HacktoxX/sodimm-storage-box/src/dimensions.scad

/*
 * Zentrale abgeleitete Maße.
 *
 * Koordinatenkonvention:
 *   X: entlang der langen Kante jedes SO-DIMMs
 *   Y: quer zu den Aufbewahrungsreihen
 *   Z: vom tiefsten Stapelmerkmal bis zur offenen Oberseite
 *
 * Merkmalsmodule verwenden diese Werte statt Berechnungen zu wiederholen.
 * Alle Maße sind in Millimetern angegeben, sofern nicht anders vermerkt.
 */

// Primitive Eingaben prüfen, bevor abgeleitete Werte durch sie dividieren.
assert(
    sodimm_length > 0 && sodimm_height > 0 && sodimm_thickness > 0,
    "Alle nominellen SO-DIMM-Maße müssen positiv sein."
);
assert(
    slots_per_row >= 1 && slots_per_row == floor(slots_per_row),
    "slots_per_row muss eine ganze Zahl von mindestens 1 sein."
);
assert(
    row_count >= 1 && row_count == floor(row_count),
    "row_count muss eine ganze Zahl von mindestens 1 sein."
);
assert(
    full_box_short_rows >= 1 &&
    full_box_short_rows <= row_count &&
    full_box_short_rows == floor(full_box_short_rows),
    "full_box_short_rows muss eine ganze Zahl zwischen 1 und row_count sein."
);
assert(
    nozzle_diameter > 0,
    "nozzle_diameter muss positiv sein."
);
assert(
    layer_height > 0,
    "layer_height muss positiv sein."
);
assert(
    wall_thickness >= (2 * nozzle_diameter),
    "wall_thickness muss mindestens zwei Düsendurchmessern entsprechen."
);
assert(
    bottom_thickness >= (3 * layer_height),
    "bottom_thickness muss mindestens drei Druckschichten entsprechen."
);
assert(
    slot_length_clearance >= 0,
    "slot_length_clearance darf nicht negativ sein."
);
assert(
    slot_thickness_clearance >= 0,
    "slot_thickness_clearance darf nicht negativ sein."
);
assert(
    center_gap >= 0 && row_spacing >= 0,
    "Slotabstände dürfen nicht negativ sein."
);
assert(
    outer_margin_x >= 0 && outer_margin_y >= 0,
    "Außenränder dürfen nicht negativ sein."
);
assert(
    curve_resolution >= 12 &&
    curve_resolution == floor(curve_resolution),
    "curve_resolution muss eine ganze Zahl von mindestens 12 sein."
);
assert(
    body_material_reliefs == true || body_material_reliefs == false,
    "body_material_reliefs muss true oder false sein."
);
assert(
    insertion_depth > 0 && insertion_depth <= sodimm_height,
    "insertion_depth muss positiv sein und darf sodimm_height nicht überschreiten."
);
assert(
    access_grip_depth > 0 && access_grip_depth < insertion_depth,
    "access_grip_depth muss positiv und kleiner als insertion_depth sein."
);
assert(
    stacking_clearance >= 0,
    "stacking_clearance darf nicht negativ sein."
);
assert(
    stacking_feature_height > 0 && stacking_feature_top_width > 0,
    "Die Maße der Stapelfunktion müssen positiv sein."
);
assert(
    stacking_chamfer_angle > 0 && stacking_chamfer_angle <= 45,
    "Stapelfasen über 45 Grad sind nicht garantiert supportfrei druckbar."
);
assert(
    stacking_standoff > 0 &&
    stacking_standoff < stacking_feature_height,
    "stacking_standoff muss positiv und kleiner als stacking_feature_height sein."
);
assert(
    stacking_module_vertical_clearance >= 0,
    "stacking_module_vertical_clearance darf nicht negativ sein."
);
assert(
    stacking_min_feature_thickness >= (2 * nozzle_diameter),
    "stacking_min_feature_thickness muss mindestens zwei Düsendurchmessern entsprechen."
);
assert(
    stacking_min_edge_distance >= (2 * nozzle_diameter),
    "stacking_min_edge_distance muss mindestens zwei Düsendurchmessern entsprechen."
);
assert(
    stacking_min_backing_thickness >= (3 * layer_height),
    "stacking_min_backing_thickness muss mindestens drei Schichten entsprechen."
);
assert(
    corner_radius >= wall_thickness,
    "corner_radius muss für einen gültigen Innenradius mindestens wall_thickness entsprechen."
);
assert(
    label_mode == "engraved" ||
    label_mode == "raised",
    "label_mode muss \"engraved\" oder \"raised\" sein."
);
assert(
    label_width > 0 && label_height > 0 && label_depth > 0,
    "Die Beschriftungsmaße müssen positiv sein."
);
assert(
    is_string(label_text) && len(label_text) > 0,
    "label_text muss eine nichtleere Zeichenkette sein."
);
assert(
    is_string(label_font) && len(label_font) > 0,
    "label_font muss eine nichtleere Zeichenkette sein."
);
assert(
    label_depth >= layer_height &&
    label_panel_recess_depth >= layer_height,
    "Beschriftungs- und Feldtiefe müssen mindestens einer Schicht entsprechen."
);
assert(
    label_panel_bevel > 0 &&
    label_panel_bevel <= label_panel_recess_depth,
    "Die Feldfase muss positiv sein und darf die Feldtiefe nicht überschreiten."
);
assert(
    label_panel_padding >= nozzle_diameter,
    "Der Innenabstand des Beschriftungsfelds muss mindestens einer Düsenbreite entsprechen."
);
assert(
    label_panel_corner_radius > label_panel_bevel,
    "Der Feldradius muss größer als die Feldfase sein."
);
assert(
    label_character_width_ratio > 0,
    "label_character_width_ratio muss positiv sein."
);
assert(
    label_min_font_size > 0 &&
    label_min_font_size <= label_max_font_size,
    "label_min_font_size muss positiv und darf nicht größer als label_max_font_size sein."
);
assert(
    printer_build_x > 0 && printer_build_y > 0 && printer_build_z > 0,
    "Die Maße des Druckerbauraums müssen positiv sein."
);

// Ein Slot addiert explizites Fertigungsspiel zur nominellen Modulhülle.
slot_length = sodimm_length + slot_length_clearance;
function slot_width_with_clearance(thickness_clearance) =
    sodimm_thickness + thickness_clearance;
slot_width = slot_width_with_clearance(slot_thickness_clearance);

/*
 * Gemeinsame Matrixfunktionen sind die einzige Quelle für Slotfeld- und
 * Körpermaße. Kalibrierkörper, vollständige Box und Kurztest verwenden damit
 * dieselbe Positions- und Abstandskette.
 */
function slot_matrix_length_for(columns) =
    (columns * slot_length) + ((columns - 1) * center_gap);

function slot_matrix_width_for(rows, thickness_clearance) =
    (rows * slot_width_with_clearance(thickness_clearance)) +
    ((rows - 1) * row_spacing);

function storage_body_length_with_margin_for(columns, outer_margin) =
    slot_matrix_length_for(columns) +
    (2 * (outer_margin + wall_thickness));

function storage_body_width_with_margin_for(
    rows,
    thickness_clearance,
    outer_margin
) =
    slot_matrix_width_for(rows, thickness_clearance) +
    (2 * (outer_margin + wall_thickness));

function storage_body_length_for(columns) =
    storage_body_length_with_margin_for(columns, outer_margin_x);

function storage_body_width_for(rows, thickness_clearance) =
    storage_body_width_with_margin_for(
        rows,
        thickness_clearance,
        outer_margin_y
    );

// Das Slotfeld enthält alle Slots und nur die Abstände zwischen Nachbarn.
slot_area_length = slot_matrix_length_for(slots_per_row);
slot_area_width =
    slot_matrix_width_for(row_count, slot_thickness_clearance);

// Der Hauptkörper umschließt das Slotfeld mit Funktionsrand und Außenwand.
body_length = storage_body_length_for(slots_per_row);
body_width = storage_body_width_for(row_count, slot_thickness_clearance);
body_height = bottom_thickness + insertion_depth;

/*
 * Die Stapelschnittstelle ist noch nicht in den Grundkörper integriert. Für
 * die langfristige P1S-Prüfung wird ihre volle Höhe dennoch als konservative
 * zusätzliche Kontur oberhalb des unveränderten Körpers reserviert.
 */
box_length = body_length;
box_width = body_width;
box_height = body_height + stacking_feature_height;

// Die Kapazität wird einmal abgeleitet, damit jedes Teilsystem denselben Wert meldet.
total_slot_count = slots_per_row * row_count;

// Der Kurztest reduziert ausschließlich die Reihenzahl derselben Matrix.
full_box_short_slot_count = slots_per_row * full_box_short_rows;
full_box_short_slot_area_length =
    slot_matrix_length_for(slots_per_row);
full_box_short_slot_area_width =
    slot_matrix_width_for(
        full_box_short_rows,
        slot_thickness_clearance
    );
full_box_short_body_length = storage_body_length_for(slots_per_row);
full_box_short_body_width =
    storage_body_width_for(
        full_box_short_rows,
        slot_thickness_clearance
    );
full_box_short_body_height = body_height;

/*
 * Funktionale Entnahmezone und materialoptimierte Randbereiche.
 *
 * Die Randreliefs enden so weit vor den erweiterten Slotöffnungen, dass die
 * minimale Außenwand exakt wall_thickness erhält. Sie sind nach oben offen
 * und erzeugen daher weder Decken noch Brücken.
 */
access_grip_bottom_width = center_gap;
access_grip_top_width =
    access_grip_bottom_width + (2 * access_grip_depth);
access_grip_remaining_web_height = body_height - access_grip_depth;

body_relief_depth_x = outer_margin_x - slot_chamfer_expansion;
body_relief_depth_y = outer_margin_y - slot_chamfer_expansion;
body_relief_corner_radius = wall_thickness / 2;
body_relief_height = body_height - bottom_thickness;
body_calculation_epsilon = layer_height / 100;

body_min_outer_wall_x =
    (wall_thickness + outer_margin_x - slot_chamfer_expansion) -
    body_relief_depth_x;
body_min_outer_wall_y =
    (wall_thickness + outer_margin_y - slot_chamfer_expansion) -
    body_relief_depth_y;
body_load_bearing_row_web_width = row_spacing;
body_entry_row_web_width =
    row_spacing - (2 * slot_chamfer_expansion);
body_center_web_width = center_gap;
body_entry_center_web_width =
    center_gap - (2 * slot_chamfer_expansion);
body_contact_floor_thickness =
    bottom_thickness - slot_contact_relief_depth;

full_box_build_volume_ok =
    body_length <= printer_build_x &&
    body_width <= printer_build_y &&
    body_height <= printer_build_z;
full_box_build_volume_remaining_x = printer_build_x - body_length;
full_box_build_volume_remaining_y = printer_build_y - body_width;
full_box_build_volume_remaining_z = printer_build_z - body_height;

full_box_short_build_volume_ok =
    full_box_short_body_length <= printer_build_x &&
    full_box_short_body_width <= printer_build_y &&
    full_box_short_body_height <= printer_build_z;

// Ursprung des Slotfelds, gemessen von der unteren Außenecke des Körpers.
slot_start_x = wall_thickness + outer_margin_x;
slot_start_y = wall_thickness + outer_margin_y;

// Voll- und Kurzgrundkörper beginnen unverändert auf dem Druckbett.
body_start_z = 0;
slot_start_z = body_start_z + bottom_thickness;

// Diagnosewerte werden hier abgeleitet, um Rechnungen in echo() nicht zu wiederholen.
exposed_sodimm_height = sodimm_height - insertion_depth;
wall_line_count = wall_thickness / nozzle_diameter;
bottom_layer_count = bottom_thickness / layer_height;

/*
 * Die Bauraumprüfung verwendet die vollständige druckbare Hülle. box_height
 * enthält bereits die reservierte spätere Konturhöhe. X und Y bleiben bis zur
 * physischen Freigabe der Schnittstelle identisch mit dem Grundkörper.
 */
build_volume_ok =
    box_length <= printer_build_x &&
    box_width <= printer_build_y &&
    box_height <= printer_build_z;
build_volume_remaining_x = printer_build_x - box_length;
build_volume_remaining_y = printer_build_y - box_width;
build_volume_remaining_z = printer_build_z - box_height;

// Die vollständige Kette abgeleiteter Innen- und Außenmaße prüfen.
assert(
    slot_length > 0 && slot_width > 0,
    "Die abgeleiteten Slotmaße müssen positiv sein."
);
assert(
    slot_area_length > 0 && slot_area_width > 0,
    "Die abgeleiteten Maße des Slotfelds müssen positiv sein."
);
assert(
    body_length > 0 && body_width > 0 && body_height > 0,
    "Die abgeleiteten Körpermaße müssen positiv sein."
);
assert(
    box_length > 0 && box_width > 0 && box_height > 0,
    "Die abgeleiteten Gesamtmaße der Box müssen positiv sein."
);
assert(
    corner_radius <= (min(body_length, body_width) / 2),
    "corner_radius darf die Hälfte der kürzesten Körperabmessung nicht überschreiten."
);
assert(
    exposed_sodimm_height >= 0,
    "Die abgeleitete freiliegende SO-DIMM-Höhe darf nicht negativ sein."
);
assert(
    row_spacing >= wall_thickness,
    "row_spacing muss für einen tragenden Reihensteg mindestens wall_thickness entsprechen."
);
assert(
    center_gap >= wall_thickness,
    "center_gap muss für einen tragenden Mittelsteg mindestens wall_thickness entsprechen."
);
assert(
    access_grip_remaining_web_height >=
        (bottom_thickness + wall_thickness),
    "Die Entnahmezone lässt zu wenig tragende Höhe im Mittelsteg stehen."
);
assert(
    body_entry_row_web_width > 0,
    "Die Einführfasen benachbarter Reihen kollidieren."
);
assert(
    body_entry_center_web_width >= wall_thickness,
    "Die Einführfasen lassen am Mittelsteg weniger als wall_thickness stehen."
);
assert(
    body_contact_floor_thickness >= (3 * layer_height),
    "Der Boden unter der Kontaktentlastung muss mindestens drei Schichten stark bleiben."
);
assert(
    !body_material_reliefs ||
    (
        body_relief_depth_x > 0 &&
        body_relief_depth_y > 0 &&
        body_relief_height > 0
    ),
    "Die aktivierten Materialreliefs benötigen positive Abmessungen."
);
assert(
    !body_material_reliefs ||
    (
        body_min_outer_wall_x + body_calculation_epsilon >= wall_thickness &&
        body_min_outer_wall_y + body_calculation_epsilon >= wall_thickness
    ),
    "Die Materialreliefs unterschreiten die minimale Außenwandstärke."
);
assert(
    body_length <= printer_build_x,
    str(
        "Die Grundkörperlänge von ",
        body_length,
        " mm überschreitet printer_build_x von ",
        printer_build_x,
        " mm."
    )
);
assert(
    body_width <= printer_build_y,
    str(
        "Die Grundkörperbreite von ",
        body_width,
        " mm überschreitet printer_build_y von ",
        printer_build_y,
        " mm."
    )
);
assert(
    body_height <= printer_build_z,
    str(
        "Die Grundkörperhöhe von ",
        body_height,
        " mm überschreitet printer_build_z von ",
        printer_build_z,
        " mm."
    )
);
assert(
    full_box_short_body_length <= printer_build_x,
    "Der kurze Grundkörper überschreitet printer_build_x."
);
assert(
    full_box_short_body_width <= printer_build_y,
    "Der kurze Grundkörper überschreitet printer_build_y."
);
assert(
    full_box_short_body_height <= printer_build_z,
    "Der kurze Grundkörper überschreitet printer_build_z."
);

// Auf genau der Druckerachse fehlschlagen, die die Box nicht aufnehmen kann.
assert(
    box_length <= printer_build_x,
    str(
        "Die Boxlänge von ",
        box_length,
        " mm überschreitet printer_build_x von ",
        printer_build_x,
        " mm."
    )
);
assert(
    box_width <= printer_build_y,
    str(
        "Die Boxbreite von ",
        box_width,
        " mm überschreitet printer_build_y von ",
        printer_build_y,
        " mm."
    )
);
assert(
    box_height <= printer_build_z,
    str(
        "Die Boxhöhe von ",
        box_height,
        " mm überschreitet printer_build_z von ",
        printer_build_z,
        " mm."
    )
);

/*
 * Vier-Slot-Kalibrierkörper
 *
 * Diese Funktionen halten die Testvarianten parametergesteuert. Die Slotmaße
 * der späteren Box bleiben die verbindliche Quelle; nur das Dickenspiel
 * unterscheidet sich zwischen den Kalibrierkörpern.
 */
function slot_test_field_length_for(columns) =
    slot_matrix_length_for(columns);

function slot_test_field_width_for(thickness_clearance, rows) =
    slot_matrix_width_for(rows, thickness_clearance);

function slot_test_body_length_for(columns) =
    slot_test_field_length_for(columns) + (2 * slot_test_edge_width);

function slot_test_body_width_for(thickness_clearance, rows) =
    slot_test_field_width_for(thickness_clearance, rows) +
    (2 * slot_test_edge_width);

assert(
    render_mode == "debug" ||
    render_mode == "slot_test" ||
    render_mode == "full_box" ||
    render_mode == "full_box_short" ||
    render_mode == "stacking_test" ||
    render_mode == "stacking_test_variants" ||
    render_mode == "final_box",
    "render_mode muss \"debug\", \"slot_test\", \"full_box\", \"full_box_short\", \"stacking_test\", \"stacking_test_variants\" oder \"final_box\" sein."
);
assert(
    slot_test_rows >= 1 && slot_test_rows == floor(slot_test_rows),
    "slot_test_rows muss eine ganze Zahl von mindestens 1 sein."
);
assert(
    slot_test_columns >= 1 &&
    slot_test_columns == floor(slot_test_columns),
    "slot_test_columns muss eine ganze Zahl von mindestens 1 sein."
);
assert(
    slot_chamfer_height > 0,
    "slot_chamfer_height muss positiv sein."
);
assert(
    slot_chamfer_expansion >= 0,
    "slot_chamfer_expansion darf nicht negativ sein."
);
assert(
    slot_chamfer_expansion <= slot_chamfer_height,
    "slot_chamfer_expansion darf slot_chamfer_height nicht überschreiten; die Einführfläche wäre steiler als 45 Grad."
);
assert(
    slot_chamfer_height < insertion_depth,
    "slot_chamfer_height muss kleiner als insertion_depth sein."
);
assert(
    slot_contact_support_length > 0 &&
    (2 * slot_contact_support_length) < slot_length,
    "slot_contact_support_length muss einen offenen Bereich für die Kontaktfreistellung lassen."
);
assert(
    slot_contact_relief_depth > 0,
    "slot_contact_relief_depth muss positiv sein."
);
assert(
    (bottom_thickness - slot_contact_relief_depth) >= (3 * layer_height),
    "Der Boden unter der Kontaktfreistellung muss mindestens drei Schichten stark bleiben."
);
assert(
    slot_test_outer_margin >= wall_thickness,
    "slot_test_outer_margin muss mindestens wall_thickness erhalten."
);
assert(
    access_grip_depth > 0,
    "access_grip_depth muss positiv sein."
);
assert(
    slot_test_variant_mode == true || slot_test_variant_mode == false,
    "slot_test_variant_mode muss true oder false sein."
);
assert(
    len(slot_test_clearance_variants) >= 1,
    "slot_test_clearance_variants muss mindestens einen Wert enthalten."
);
for (variant_clearance = slot_test_clearance_variants) {
    assert(
        variant_clearance >= 0,
        "Jedes Dickenspiel des Slot-Tests muss nichtnegativ sein."
    );
}
assert(
    slot_test_variant_spacing >= wall_thickness,
    "slot_test_variant_spacing muss mindestens wall_thickness entsprechen."
);

// Der Rand des Testkörpers ist nie dünner als die Wand der späteren Box.
slot_test_edge_width = max(wall_thickness, slot_test_outer_margin);

// Der Test verwendet Slotlänge, Mittelabstand und Reihenabstand der späteren Box.
slot_test_slot_length = slot_length;
slot_test_slot_width =
    slot_width_with_clearance(slot_thickness_clearance);
slot_test_field_length = slot_test_field_length_for(slot_test_columns);
slot_test_field_width =
    slot_test_field_width_for(slot_thickness_clearance, slot_test_rows);

slot_test_body_length = slot_test_body_length_for(slot_test_columns);
slot_test_body_width =
    slot_test_body_width_for(slot_thickness_clearance, slot_test_rows);
slot_test_body_height = bottom_thickness + insertion_depth;

// Die Slotanordnung beginnt hinter der kompakten Außenwand.
slot_test_slot_start_x = slot_test_edge_width;
slot_test_slot_start_y = slot_test_edge_width;
slot_test_slot_start_z = bottom_thickness;

// Die gerade Führung endet am Beginn der symmetrischen oberen Fase.
slot_straight_guide_depth = insertion_depth - slot_chamfer_height;

/*
 * Zwei Endauflagen bleiben auf dem nominellen Bodenniveau stehen. Die
 * Freistellung dazwischen schützt die Kontaktkante und erhält einen
 * druckbaren geschlossenen Boden.
 */
slot_contact_relief_length =
    slot_test_slot_length - (2 * slot_contact_support_length);
slot_contact_floor_thickness =
    bottom_thickness - slot_contact_relief_depth;

/*
 * Die Entnahmeöffnung beginnt mit dem vollständigen Mittelabstand und erweitert
 * sich horizontal um einen Millimeter je vertikalem Millimeter. Ihre
 * 45-Grad-Flächen sind supportfrei.
 */
slot_test_grip_bottom_width = center_gap;
slot_test_grip_top_width = access_grip_top_width;
slot_test_remaining_center_web_height =
    access_grip_remaining_web_height;

// Explizite Stegberechnungen belegen, dass benachbarte Fasen nicht kollidieren.
slot_test_column_web_width = center_gap;
slot_test_row_web_width = row_spacing;
slot_test_chamfer_column_web_width =
    slot_test_column_web_width - (2 * slot_chamfer_expansion);
slot_test_chamfer_row_web_width =
    slot_test_row_web_width - (2 * slot_chamfer_expansion);
slot_test_chamfer_outer_wall =
    slot_test_edge_width - slot_chamfer_expansion;

// Eine aus der Schichthöhe abgeleitete Überlappung vermeidet koplanare Booleans.
modeling_overlap = layer_height / 10;
slot_test_boolean_overlap = modeling_overlap;

// Der Variantenabstand verwendet unabhängig von der Reihenfolge den breitesten Körper.
slot_test_variant_count = len(slot_test_clearance_variants);
slot_test_max_variant_clearance =
    slot_test_variant_count > 0
        ? max(slot_test_clearance_variants)
        : slot_thickness_clearance;
slot_test_max_variant_body_width =
    slot_test_body_width_for(
        slot_test_max_variant_clearance,
        slot_test_rows
    );
slot_test_variant_pitch =
    slot_test_max_variant_body_width + slot_test_variant_spacing;
slot_test_variants_width =
    (slot_test_variant_count * slot_test_max_variant_body_width) +
    ((slot_test_variant_count - 1) * slot_test_variant_spacing);

// Die gesamte Renderhülle wechselt zwischen Einzelkörper und Variantenanordnung.
slot_test_render_length = slot_test_body_length;
slot_test_render_width =
    slot_test_variant_mode
        ? slot_test_variants_width
        : slot_test_body_width;
slot_test_render_height = slot_test_body_height;
slot_test_build_volume_ok =
    slot_test_render_length <= printer_build_x &&
    slot_test_render_width <= printer_build_y &&
    slot_test_render_height <= printer_build_z;

assert(
    slot_test_slot_width > 0,
    "Die abgeleitete Breite des Slot-Tests muss positiv sein."
);
assert(
    slot_test_body_length > 0 &&
    slot_test_body_width > 0 &&
    slot_test_body_height > 0,
    "Alle abgeleiteten Körpermaße des Slot-Tests müssen positiv sein."
);
assert(
    slot_contact_relief_length > 0,
    "Die Kontaktauflagen lassen keine mittige Kontaktfreistellung übrig."
);
assert(
    slot_test_remaining_center_web_height >=
        (bottom_thickness + wall_thickness),
    "Die Entnahmefreistellung lässt über dem Boden weniger als wall_thickness stehen."
);
assert(
    slot_test_chamfer_column_web_width > 0,
    "Die Spaltenfasen kollidieren über center_gap hinweg."
);
assert(
    slot_test_chamfer_row_web_width > 0,
    "Die Reihenfasen kollidieren über row_spacing hinweg."
);
assert(
    slot_test_chamfer_outer_wall >= (2 * nozzle_diameter),
    "Die Fase lässt an der Außenwand weniger als zwei Düsendurchmesser stehen."
);
assert(
    slot_test_render_length <= printer_build_x,
    "Der Slot-Test überschreitet printer_build_x."
);
assert(
    slot_test_render_width <= printer_build_y,
    "Der Slot-Test überschreitet printer_build_y."
);
assert(
    slot_test_render_height <= printer_build_z,
    "Der Slot-Test überschreitet printer_build_z."
);

/*
 * Kalibriergeometrie der selbstzentrierenden Stapelschnittstelle.
 *
 * Der Winkel wird gegenüber der Druckebene gemessen. Bei 45 Grad entspricht
 * der horizontale Lauf exakt der vertikalen Höhe. Männliche und weibliche
 * Kontur greifen ausschließlich auf diese Funktionen zurück.
 */
function stacking_slope_run_per_height_for(chamfer_angle) =
    1 / tan(chamfer_angle);

function stacking_male_base_width_for(
    feature_height,
    feature_top_width,
    chamfer_angle
) =
    feature_top_width +
    (
        2 *
        feature_height *
        stacking_slope_run_per_height_for(chamfer_angle)
    );

function stacking_engagement_depth_for(feature_height, standoff) =
    feature_height - standoff;

function stacking_male_width_at_height_for(
    height,
    feature_height,
    feature_top_width,
    chamfer_angle
) =
    feature_top_width +
    (
        2 *
        (feature_height - height) *
        stacking_slope_run_per_height_for(chamfer_angle)
    );

function stacking_female_opening_width_for(
    clearance,
    feature_height,
    feature_top_width,
    chamfer_angle,
    standoff
) =
    stacking_male_width_at_height_for(
        standoff,
        feature_height,
        feature_top_width,
        chamfer_angle
    ) + clearance;

function stacking_female_depth_for(
    clearance,
    feature_height,
    feature_top_width,
    chamfer_angle,
    standoff
) =
    stacking_female_opening_width_for(
        clearance,
        feature_height,
        feature_top_width,
        chamfer_angle,
        standoff
    ) /
    (
        2 *
        stacking_slope_run_per_height_for(chamfer_angle)
    );

stacking_slope_run_per_height =
    stacking_slope_run_per_height_for(stacking_chamfer_angle);
stacking_slope_run =
    stacking_feature_height * stacking_slope_run_per_height;
stacking_male_base_width =
    stacking_male_base_width_for(
        stacking_feature_height,
        stacking_feature_top_width,
        stacking_chamfer_angle
    );
stacking_engagement_depth =
    stacking_engagement_depth_for(
        stacking_feature_height,
        stacking_standoff
    );
stacking_female_opening_width =
    stacking_female_opening_width_for(
        stacking_clearance,
        stacking_feature_height,
        stacking_feature_top_width,
        stacking_chamfer_angle,
        stacking_standoff
    );
stacking_female_depth =
    stacking_female_depth_for(
        stacking_clearance,
        stacking_feature_height,
        stacking_feature_top_width,
        stacking_chamfer_angle,
        stacking_standoff
    );

// Das Gesamtspiel wird symmetrisch auf die beiden gegenüberliegenden Flanken verteilt.
stacking_clearance_per_side = stacking_clearance / 2;
stacking_female_width_at_male_top =
    stacking_female_opening_width -
    (
        2 *
        stacking_engagement_depth *
        stacking_slope_run_per_height
    );
stacking_calculated_total_clearance =
    stacking_female_width_at_male_top -
    stacking_feature_top_width;
stacking_roof_clearance =
    stacking_female_depth - stacking_engagement_depth;
stacking_lateral_capture =
    (
        stacking_female_opening_width -
        stacking_feature_top_width
    ) / 2;

// Zwei parallele Auflagenpaare tragen die obere Hälfte, bevor die Flanken klemmen können.
stacking_support_land_count = 4;
stacking_support_land_area =
    stacking_support_land_count *
    stacking_support_land_length *
    stacking_support_land_width;

stacking_test_male_outer_length =
    stacking_test_frame_length + stacking_male_base_width;
stacking_test_male_outer_width =
    stacking_test_frame_width + stacking_male_base_width;
stacking_test_male_inner_length =
    stacking_test_frame_length - stacking_male_base_width;
stacking_test_male_inner_width =
    stacking_test_frame_width - stacking_male_base_width;
stacking_test_female_outer_length =
    stacking_test_frame_length +
    stacking_male_base_width +
    stacking_clearance;
stacking_test_female_outer_width =
    stacking_test_frame_width +
    stacking_male_base_width +
    stacking_clearance;
stacking_test_max_clearance = max(stacking_clearance_variants);
stacking_test_max_female_outer_length =
    stacking_test_frame_length +
    stacking_male_base_width +
    stacking_test_max_clearance;
stacking_test_max_female_outer_width =
    stacking_test_frame_width +
    stacking_male_base_width +
    stacking_test_max_clearance;
stacking_test_interface_outer_length = max(
    stacking_test_male_outer_length,
    stacking_test_max_female_outer_length
);
stacking_test_interface_outer_width = max(
    stacking_test_male_outer_width,
    stacking_test_max_female_outer_width
);
stacking_test_edge_distance_x =
    (
        stacking_test_body_length -
        stacking_test_interface_outer_length
    ) / 2;
stacking_test_edge_distance_y =
    (
        stacking_test_body_width -
        stacking_test_interface_outer_width
    ) / 2;
stacking_test_female_backing =
    stacking_test_top_thickness - stacking_female_depth;
stacking_test_bottom_height =
    stacking_test_bottom_thickness + stacking_feature_height;
stacking_test_top_height = stacking_test_top_thickness;
stacking_test_pair_length = stacking_test_body_length;
stacking_test_pair_width =
    (2 * stacking_test_body_width) + stacking_test_part_spacing;
stacking_test_pair_height =
    max(stacking_test_bottom_height, stacking_test_top_height);

stacking_test_variant_count = len(stacking_clearance_variants);
stacking_test_variant_rows =
    ceil(stacking_test_variant_count / stacking_test_variant_columns);
stacking_test_variants_length =
    (
        stacking_test_variant_columns *
        stacking_test_pair_length
    ) +
    (
        (stacking_test_variant_columns - 1) *
        stacking_test_variant_spacing
    );
stacking_test_variants_width =
    (stacking_test_variant_rows * stacking_test_pair_width) +
    (
        (stacking_test_variant_rows - 1) *
        stacking_test_variant_spacing
    );
stacking_test_variants_height = stacking_test_pair_height;

stacking_test_build_volume_ok =
    stacking_test_pair_length <= printer_build_x &&
    stacking_test_pair_width <= printer_build_y &&
    stacking_test_pair_height <= printer_build_z;
stacking_test_variants_build_volume_ok =
    stacking_test_variants_length <= printer_build_x &&
    stacking_test_variants_width <= printer_build_y &&
    stacking_test_variants_height <= printer_build_z;

assert(
    stacking_feature_top_width >= stacking_min_feature_thickness,
    "Die freie Krone der Stapelfeder unterschreitet stacking_min_feature_thickness."
);
assert(
    stacking_male_base_width > stacking_feature_top_width,
    "Die Stapelfeder benötigt eine breitere Basis als Krone."
);
assert(
    stacking_standoff >=
        (exposed_sodimm_height + stacking_module_vertical_clearance),
    "Die Stapelhöhe lässt nicht genügend Abstand über den eingesetzten SO-DIMMs."
);
assert(
    stacking_engagement_depth > 0,
    "Die Stapelschnittstelle benötigt eine positive Führungstiefe."
);
assert(
    stacking_female_opening_width > stacking_feature_top_width,
    "Die Stapelnut muss die Krone der Stapelfeder aufnehmen können."
);
assert(
    abs(stacking_calculated_total_clearance - stacking_clearance) <=
        body_calculation_epsilon,
    "Das abgeleitete Gesamtspiel der Stapelschnittstelle ist inkonsistent."
);
assert(
    stacking_roof_clearance > 0,
    "Das 45-Grad-Dach der Stapelnut kollidiert mit der Federkrone."
);
assert(
    stacking_test_body_length > 0 &&
    stacking_test_body_width > 0 &&
    stacking_test_bottom_thickness > 0 &&
    stacking_test_top_thickness > 0,
    "Alle Grundmaße des Stapeltests müssen positiv sein."
);
assert(
    stacking_test_corner_radius >= nozzle_diameter &&
    stacking_test_corner_radius <=
        (min(stacking_test_body_length, stacking_test_body_width) / 2),
    "stacking_test_corner_radius ist für den Testkörper ungültig."
);
assert(
    stacking_test_frame_length > stacking_male_base_width &&
    stacking_test_frame_width > stacking_male_base_width,
    "Der Stapelrahmen benötigt eine positive innere Öffnung."
);
assert(
    stacking_test_edge_distance_x >= stacking_min_edge_distance &&
    stacking_test_edge_distance_y >= stacking_min_edge_distance,
    "Die Stapelfeder unterschreitet den Mindestabstand zur Außenkante des Testkörpers."
);
assert(
    stacking_test_female_backing >= stacking_min_backing_thickness,
    "Über dem Dach der Stapelnut bleibt zu wenig tragendes Material."
);
assert(
    stacking_support_land_length >= stacking_min_feature_thickness &&
    stacking_support_land_width >= stacking_min_feature_thickness,
    "Die Stapelauflagen unterschreiten stacking_min_feature_thickness."
);
assert(
    (
        stacking_support_land_offset_x +
        (stacking_support_land_length / 2)
    ) < (stacking_test_male_inner_length / 2) &&
    (
        stacking_support_land_offset_y +
        (stacking_support_land_width / 2)
    ) <=
        (
            (stacking_test_male_inner_width / 2) +
            modeling_overlap
        ),
    "Die Stapelauflagen kollidieren mit der Führung oder verlassen deren Innenbereich."
);
assert(
    stacking_test_mark_height > (3 * nozzle_diameter) &&
    stacking_test_mark_depth > 0 &&
    stacking_test_mark_depth < stacking_test_bottom_thickness,
    "Die Kennzeichnung des Stapeltests ist nicht druckbar dimensioniert."
);
assert(
    stacking_test_part_spacing >= stacking_min_feature_thickness,
    "Der Abstand zwischen Unter- und Oberteil ist zu klein."
);
assert(
    stacking_test_variant_spacing >= stacking_min_feature_thickness,
    "Der Abstand zwischen Stapelvarianten ist zu klein."
);
assert(
    stacking_test_variant_count >= 4,
    "stacking_clearance_variants muss mindestens vier Werte enthalten."
);
assert(
    stacking_test_variant_columns >= 1 &&
    stacking_test_variant_columns == floor(stacking_test_variant_columns),
    "stacking_test_variant_columns muss eine ganze Zahl von mindestens 1 sein."
);
for (variant_clearance = stacking_clearance_variants) {
    variant_female_opening =
        stacking_female_opening_width_for(
            variant_clearance,
            stacking_feature_height,
            stacking_feature_top_width,
            stacking_chamfer_angle,
            stacking_standoff
        );
    variant_calculated_clearance =
        variant_female_opening -
        (
            2 *
            stacking_engagement_depth *
            stacking_slope_run_per_height
        ) -
        stacking_feature_top_width;

    assert(
        variant_clearance >= 0,
        "Jedes Gesamtspiel des Stapeltests muss nichtnegativ sein."
    );
    assert(
        abs(variant_calculated_clearance - variant_clearance) <=
            body_calculation_epsilon,
        "Eine Stapelvariante erzeugt in Sollposition nicht das konfigurierte Gesamtspiel."
    );
    assert(
        stacking_test_top_thickness -
        stacking_female_depth_for(
            variant_clearance,
            stacking_feature_height,
            stacking_feature_top_width,
            stacking_chamfer_angle,
            stacking_standoff
        ) >= stacking_min_backing_thickness,
        "Eine Stapelvariante lässt zu wenig Material über dem Nutdach stehen."
    );
}
assert(
    stacking_test_build_volume_ok,
    "Das Stapeltestpaar überschreitet den konfigurierten Druckerbauraum."
);
assert(
    stacking_test_variants_build_volume_ok,
    "Die Stapeltestvarianten überschreiten den konfigurierten Druckerbauraum."
);

/*
 * Produktionsreife 20-Slot-Box mit integrierter Stapelschnittstelle.
 *
 * Der zusätzliche Funktionsrand wird aus der validierten Feder-/Nutkontur
 * berechnet und auf ein ganzzahliges Düsenraster aufgerundet. Dadurch bleiben
 * Außenform, Slotmatrix und Stapelmechanik aus einer einzigen Maßkette
 * abgeleitet, ohne die Geometrie der kalibrierten Slots zu duplizieren.
 */
function round_up_to_increment(value, increment) =
    ceil(value / increment) * increment;

function round_down_to_increment(value, increment) =
    floor(value / increment) * increment;

final_stack_frame_center_inset =
    stacking_min_edge_distance +
    ((stacking_male_base_width + stacking_clearance) / 2);
final_required_outer_margin =
    final_stack_frame_center_inset +
    (stacking_male_base_width / 2) +
    stacking_clearance -
    wall_thickness +
    slot_chamfer_expansion;
final_outer_margin_x = round_up_to_increment(
    final_required_outer_margin,
    nozzle_diameter
);
final_outer_margin_y = round_up_to_increment(
    final_required_outer_margin,
    nozzle_diameter
);

final_body_length = storage_body_length_with_margin_for(
    slots_per_row,
    final_outer_margin_x
);
final_body_width = storage_body_width_with_margin_for(
    row_count,
    slot_thickness_clearance,
    final_outer_margin_y
);
final_body_height = body_height;
final_slot_start_x = wall_thickness + final_outer_margin_x;
final_slot_start_y = wall_thickness + final_outer_margin_y;
final_slot_chamfer_edge_x =
    final_slot_start_x - slot_chamfer_expansion;
final_slot_chamfer_edge_y =
    final_slot_start_y - slot_chamfer_expansion;

final_stack_frame_length =
    final_body_length - (2 * final_stack_frame_center_inset);
final_stack_frame_width =
    final_body_width - (2 * final_stack_frame_center_inset);
final_stack_male_outer_edge_distance =
    final_stack_frame_center_inset -
    (stacking_male_base_width / 2);
final_stack_male_inner_edge_distance =
    final_stack_frame_center_inset +
    (stacking_male_base_width / 2);
final_stack_female_straight_edge_distance =
    final_stack_frame_center_inset -
    (stacking_female_opening_width / 2);
final_stack_female_tangential_edge_distance =
    final_stack_frame_center_inset -
    ((stacking_male_base_width + stacking_clearance) / 2);
final_stack_female_inner_edge_distance =
    final_stack_frame_center_inset +
    (stacking_female_opening_width / 2);

final_male_to_slot_clearance_x =
    final_slot_chamfer_edge_x -
    final_stack_male_inner_edge_distance;
final_male_to_slot_clearance_y =
    final_slot_chamfer_edge_y -
    final_stack_male_inner_edge_distance;
final_female_to_slot_clearance_x =
    final_slot_chamfer_edge_x -
    final_stack_female_inner_edge_distance;
final_female_to_slot_clearance_y =
    final_slot_chamfer_edge_y -
    final_stack_female_inner_edge_distance;

// Die Reliefs bleiben topoffen und lassen unter der Feder mindestens deren
// validierte Mindestfeaturestärke stehen.
final_body_relief_depth = round_down_to_increment(
    final_stack_male_outer_edge_distance -
        stacking_min_feature_thickness,
    nozzle_diameter
);
final_relief_to_male_distance =
    final_stack_male_outer_edge_distance -
    final_body_relief_depth;
final_relief_to_female_distance =
    final_stack_female_straight_edge_distance -
    final_body_relief_depth;

// Die funktionale Entnahmezone endet vor dem tragenden Stapelperimeter.
final_grip_start_y = final_slot_chamfer_edge_y;
final_grip_width =
    slot_area_width + (2 * slot_chamfer_expansion);
final_grip_to_male_distance =
    final_grip_start_y - final_stack_male_inner_edge_distance;

// Vier robuste Auflagen definieren dieselbe Stapelhöhe wie im Testpaar.
final_support_land_outer_margin = 2 * nozzle_diameter;
final_support_land_offset_x =
    (final_body_length / 2) -
    stacking_min_edge_distance -
    (stacking_support_land_length / 2);
final_support_land_offset_y =
    (final_body_width / 2) -
    final_support_land_outer_margin -
    (stacking_support_land_width / 2);
final_support_land_inner_x_distance =
    stacking_min_edge_distance + stacking_support_land_length;
final_support_land_inner_y_distance =
    final_support_land_outer_margin + stacking_support_land_width;

/*
 * Adaptives frontseitiges Beschriftungsfeld.
 *
 * Die Schriftgröße wird konservativ aus verfügbarer Breite, Höhe und
 * Zeichenanzahl ermittelt. Gravur und Relief bleiben vollständig innerhalb
 * eines vertieften Felds und verändern daher die Außenhülle nicht.
 */
function adaptive_label_font_size_for(
    text_value,
    available_width,
    available_height
) =
    min(
        label_max_font_size,
        available_height,
        available_width /
            (max(1, len(text_value)) * label_character_width_ratio)
    );

final_label_inner_width = label_width - (2 * label_panel_bevel);
final_label_inner_height = label_height - (2 * label_panel_bevel);
final_label_content_width =
    final_label_inner_width - (2 * label_panel_padding);
final_label_content_height =
    final_label_inner_height - (2 * label_panel_padding);
final_label_font_size = adaptive_label_font_size_for(
    label_text,
    final_label_content_width,
    final_label_content_height
);
final_label_center_x = final_body_length / 2;
final_label_center_z = final_body_height / 2;
final_label_left_x = final_label_center_x - (label_width / 2);
final_label_right_x = final_label_center_x + (label_width / 2);
final_label_bottom_z = final_label_center_z - (label_height / 2);
final_label_top_z = final_label_center_z + (label_height / 2);
final_label_max_cut_depth = label_panel_recess_depth + label_depth;
final_label_to_male_distance =
    final_stack_male_outer_edge_distance - final_label_max_cut_depth;

final_stack_pitch = final_body_height + stacking_standoff;
final_box_length = final_body_length;
final_box_width = final_body_width;
final_box_height = final_body_height + stacking_feature_height;
final_two_box_stack_height = final_stack_pitch + final_box_height;
final_box_build_volume_ok =
    final_box_length <= printer_build_x &&
    final_box_width <= printer_build_y &&
    final_box_height <= printer_build_z;
final_two_box_stack_build_volume_ok =
    final_box_length <= printer_build_x &&
    final_box_width <= printer_build_y &&
    final_two_box_stack_height <= printer_build_z;

assert(
    final_outer_margin_x + body_calculation_epsilon >=
        final_required_outer_margin &&
    final_outer_margin_y + body_calculation_epsilon >=
        final_required_outer_margin,
    "Der finale Funktionsrand ist für Stapelrahmen und Slotfase zu klein."
);
assert(
    final_stack_frame_length > stacking_male_base_width &&
    final_stack_frame_width > stacking_male_base_width,
    "Der finale Stapelrahmen benötigt eine positive innere Öffnung."
);
assert(
    final_stack_female_tangential_edge_distance +
        body_calculation_epsilon >= stacking_min_edge_distance,
    "Die Stapelnut unterschreitet den Mindestabstand zur Außenkante."
);
assert(
    final_male_to_slot_clearance_x + body_calculation_epsilon >=
        stacking_clearance &&
    final_male_to_slot_clearance_y + body_calculation_epsilon >=
        stacking_clearance,
    "Die Stapelfeder liegt zu dicht an den erweiterten Slotöffnungen."
);
assert(
    final_female_to_slot_clearance_x >= stacking_clearance &&
    final_female_to_slot_clearance_y >= stacking_clearance,
    "Die Stapelnut kollidiert mit Slot- oder Kontaktbereichen."
);
assert(
    final_body_relief_depth >= (2 * nozzle_diameter),
    "Die finalen Materialreliefs sind schmaler als zwei Düsenbahnen."
);
assert(
    final_relief_to_male_distance + body_calculation_epsilon >=
        stacking_min_feature_thickness &&
    final_relief_to_female_distance >= stacking_min_feature_thickness,
    "Zwischen Materialrelief und Stapelschnittstelle bleibt zu wenig Material."
);
assert(
    final_grip_to_male_distance + body_calculation_epsilon >=
        stacking_clearance,
    "Die Entnahmezone unterbricht den tragenden Stapelperimeter."
);
assert(
    final_grip_start_y + final_grip_width <=
        final_body_width - final_grip_start_y + body_calculation_epsilon,
    "Die finale Entnahmezone ist nicht symmetrisch im Körper angeordnet."
);
assert(
    final_support_land_outer_margin >= (2 * nozzle_diameter) &&
    final_support_land_inner_x_distance <=
        final_slot_start_x + body_calculation_epsilon &&
    final_support_land_inner_y_distance <=
        final_stack_female_tangential_edge_distance +
            body_calculation_epsilon,
    "Die finalen Stapelauflagen kollidieren mit Nut, Relief oder Slotfeld."
);
assert(
    final_label_inner_width > 0 &&
    final_label_inner_height > 0 &&
    final_label_content_width > 0 &&
    final_label_content_height > 0,
    "Das Beschriftungsfeld lässt keine positive nutzbare Textfläche übrig."
);
assert(
    final_label_font_size + body_calculation_epsilon >=
        label_min_font_size,
    "label_text ist für Beschriftungsfeld und minimale Schriftgröße zu lang."
);
assert(
    final_label_left_x >= (corner_radius + wall_thickness) &&
    final_label_right_x <=
        final_body_length - corner_radius - wall_thickness,
    "Das Beschriftungsfeld liegt zu dicht an den gerundeten Außenecken."
);
assert(
    final_label_bottom_z >=
        bottom_thickness + stacking_female_depth + nozzle_diameter &&
    final_label_top_z <=
        access_grip_remaining_web_height - nozzle_diameter,
    "Das Beschriftungsfeld kollidiert mit Boden, Stapelnut oder Entnahmezone."
);
assert(
    final_label_to_male_distance + body_calculation_epsilon >=
        stacking_min_feature_thickness,
    "Hinter dem Beschriftungsfeld bleibt zu wenig Material bis zur Stapelfeder."
);
assert(
    final_box_build_volume_ok,
    "Die finale Box überschreitet den konfigurierten Druckerbauraum."
);
assert(
    final_two_box_stack_build_volume_ok,
    "Zwei final gestapelte Boxen überschreiten den konfigurierten Druckerbauraum."
);
