HacktoxX/sodimm-storage-box/src/RAM_Box.scad

include <config.scad>
include <helpers.scad>
include <dimensions.scad>
include <slots.scad>
include <body.scad>
include <stacking.scad>
include <stacking_test.scad>
include <label.scad>
include <final_box.scad>
include <debug_preview.scad>
include <slot_test.scad>
include <render.scad>
