HacktoxX/sodimm-storage-box/src/slot_test.scad

/*
 * Kompakter Kalibrierkörper zur Prüfung von vier realen SO-DIMM-Slots.
 *
 * Diese Datei enthält bewusst weder die finale Hülle noch Stapelschnittstelle
 * oder Griffgeometrie. Sie verwendet die zentralen Maße und Slotausschnitte.
 */

slot_test_label_decimal_scale = 10;

function slot_test_clearance_label(clearance) =
    str(
        floor(clearance),
        ".",
        round(
            (clearance - floor(clearance)) *
            slot_test_label_decimal_scale
        )
    );

module slot_test_identification_mark(
    body_height,
    mark_text
) {
    mark_depth = 2 * layer_height;
    mark_size = wall_thickness + (2 * layer_height);
    mark_stroke_width = nozzle_diameter;
    mark_center_x =
        slot_test_edge_width + (slot_test_slot_length / 2);
    mark_center_z = body_height / 2;

    assert(
        mark_depth > 0 && mark_depth < body_height,
        "Die Tiefe der Slot-Test-Kennzeichnung ist ungültig."
    );
    assert(
        mark_size > 0,
        "Die Außenwand ist für die Kennzeichnung des Slot-Tests zu schmal."
    );

    translate([
        mark_center_x,
        mark_depth,
        mark_center_z
    ])
        rotate([90, 0, 0])
            linear_extrude(
                height = mark_depth + slot_test_boolean_overlap
            )
                seven_segment_numeric_mark_2d(
                    mark_text = mark_text,
                    character_height = mark_size,
                    stroke_width = mark_stroke_width
                );
}

module slot_test_body(
    rows,
    columns,
    thickness_clearance,
    identification_text = ""
) {
    test_slot_width =
        slot_width_with_clearance(thickness_clearance);
    test_body_length = slot_test_body_length_for(columns);
    test_body_width =
        slot_test_body_width_for(thickness_clearance, rows);

    assert(
        rows >= 1 && columns >= 1,
        "Reihen und Spalten des Slot-Test-Körpers müssen positiv sein."
    );
    assert(
        test_slot_width > 0,
        "Der Slot-Test-Körper benötigt eine positive Slotbreite."
    );

    difference() {
        cube([
            test_body_length,
            test_body_width,
            slot_test_body_height
        ]);

        for (row_index = [0 : rows - 1]) {
            for (column_index = [0 : columns - 1]) {
                slot_center_x =
                    slot_test_edge_width +
                    (slot_test_slot_length / 2) +
                    (
                        column_index *
                        (slot_test_slot_length + center_gap)
                    );
                slot_center_y =
                    slot_test_edge_width +
                    (test_slot_width / 2) +
                    (
                        row_index *
                        (test_slot_width + row_spacing)
                    );

                translate([
                    slot_center_x,
                    slot_center_y,
                    bottom_thickness
                ]) {
                    sodimm_slot_cutout(
                        length = slot_test_slot_length,
                        width = test_slot_width,
                        depth = insertion_depth,
                        chamfer_height = slot_chamfer_height,
                        chamfer_expansion = slot_chamfer_expansion,
                        boolean_overlap = slot_test_boolean_overlap
                    );

                    sodimm_contact_relief_cutout(
                        length = slot_test_slot_length,
                        width = test_slot_width,
                        support_length = slot_contact_support_length,
                        relief_depth = slot_contact_relief_depth,
                        boolean_overlap = slot_test_boolean_overlap
                    );
                }
            }
        }

        support_free_grip_clearance(
            body_length = test_body_length,
            body_width = test_body_width,
            body_height = slot_test_body_height,
            grip_depth = access_grip_depth,
            bottom_width = slot_test_grip_bottom_width,
            top_width = slot_test_grip_top_width,
            boolean_overlap = slot_test_boolean_overlap
        );

        if (identification_text != "") {
            slot_test_identification_mark(
                body_height = slot_test_body_height,
                mark_text = identification_text
            );
        }
    }
}

module slot_test_configuration(thickness_clearance) {
    test_slot_width =
        slot_width_with_clearance(thickness_clearance);
    test_body_width =
        slot_test_body_width_for(thickness_clearance, slot_test_rows);

    echo("SO-DIMM-Slot-Test");
    echo(str(
        "Anordnung: ",
        slot_test_columns,
        " x ",
        slot_test_rows
    ));
    echo(str("Slotlänge: ", slot_test_slot_length, " mm"));
    echo(str("Slotbreite: ", test_slot_width, " mm"));
    echo(str("Einstecktiefe: ", insertion_depth, " mm"));
    echo(str("Fasenhöhe: ", slot_chamfer_height, " mm"));
    echo(str(
        "Fasenerweiterung: ",
        slot_chamfer_expansion,
        " mm"
    ));
    echo(str(
        "Abmessungen des Testkörpers: ",
        slot_test_body_length,
        " x ",
        test_body_width,
        " x ",
        slot_test_body_height,
        " mm"
    ));
    echo(str(
        "Dickenspiel: ",
        thickness_clearance,
        " mm"
    ));
    echo(str(
        "Geschätzter Modulüberstand: ",
        exposed_sodimm_height,
        " mm"
    ));
}

module slot_test() {
    if (slot_test_variant_mode) {
        for (
            variant_index =
                [0 : slot_test_variant_count - 1]
        ) {
            variant_clearance =
                slot_test_clearance_variants[variant_index];

            if (debug_mode) {
                echo(str(
                    "Variante ",
                    variant_index + 1,
                    " von ",
                    slot_test_variant_count
                ));
                slot_test_configuration(variant_clearance);
            }

            translate([
                0,
                variant_index * slot_test_variant_pitch,
                0
            ])
                slot_test_body(
                    rows = slot_test_rows,
                    columns = slot_test_columns,
                    thickness_clearance = variant_clearance,
                    identification_text =
                        slot_test_clearance_label(
                            variant_clearance
                        )
                );
        }
    } else {
        if (debug_mode) {
            slot_test_configuration(slot_thickness_clearance);
        }

        slot_test_body(
            rows = slot_test_rows,
            columns = slot_test_columns,
            thickness_clearance = slot_thickness_clearance
        );
    }
}
