HacktoxX/sodimm-storage-box/(list of files, cad)

Other CAD files:
tests/final_two_box_stack.scad
