HacktoxX/sodimm-storage-box/docs/releases/v0.2.0-slot-calibration.md

Dieses Release enthält die ersten druckbaren Modelle zur Passungskalibrierung
des parametrischen SO-DIMM-Aufbewahrungsprojekts. Die finale Box mit 20 Slots
ist noch nicht enthalten.

## Enthaltene Modelle

- **sodimm-slot-test.stl** — ein kompakter 2×2-Kalibrierkörper mit dem
  standardmäßigen gesamten Dickenspiel von 1,0 mm.
- **sodimm-slot-variants.stl** — drei getrennte Körper mit den Gravuren 0.8,
  1.0 und 1.2 für den direkten Vergleich der Toleranzen.

## Druckhinweise

- Material: PETG
- Düse: 0,4 mm
- Schichthöhe: 0,20 mm
- Ausrichtung: aufrecht wie exportiert
- Stützstrukturen: keine

Die Modelle sind für einen kurzen Passungstest vorgesehen, bevor die
vollständige Aufbewahrungsbox entwickelt wird.

## Passungsprüfung

Die dicksten SO-DIMMs verwenden, die später aufbewahrt werden sollen. Nur
stromlose Module einsetzen, ausschließlich an den Platinenkanten anfassen und
niemals mit Kraft in einen Slot drücken. Folgendes prüfen:

- Das Modul gleitet ohne Haken durch die Einführfase.
- Die Platine wird weder durchgebogen noch seitlich geklemmt.
- Die Kontaktkante bleibt über der Bodenfreistellung frei.
- Das Modul hat wenig Spiel, lässt sich aber bequem entnehmen.

Beim Druck der Varianten ist die kleinste gravierte Toleranz zu wählen, mit der
sich das Modul auf dem Zieldrucker und mit dem vorgesehenen PETG-Profil
zuverlässig einsetzen und entnehmen lässt.

## Release-Dateien reproduzieren

Im Wurzelverzeichnis des Repositorys ausführen:

```bash
scripts/export_all.sh
```

Der Befehl erzeugt beide angehängten STL-Dateien unter `exports/calibration/`,
ohne einen OpenSCAD-Quellparameter zu verändern.
