HacktoxX/sodimm-storage-box/(commit log)

2026-07-31 Initial project structure
    [RAM_Box.scad, body.scad, config.scad, dimensions.scad, helpers.scad, label.scad, slots.scad, stacking.scad]
2026-07-31 feat: add user configuration parameters
    [config.scad]
2026-07-31 feat: derive storage box dimensions
    [dimensions.scad]
2026-07-31 feat: add parameter validation
    [dimensions.scad]
2026-07-31 feat: add build volume validation
    [dimensions.scad]
2026-07-31 feat: add dimension debug preview
    [RAM_Box.scad, debug_preview.scad]
2026-07-31 feat: add slot test configuration
    [config.scad]
2026-07-31 feat: derive slot test dimensions
    [dimensions.scad]
2026-07-31 feat: implement support-free slot cutout
    [slots.scad]
2026-07-31 feat: add four-slot calibration body
    [RAM_Box.scad, debug_preview.scad, dimensions.scad, render.scad, slot_test.scad]
2026-07-31 feat: add clearance test variants
    [slot_test.scad]
2026-07-31 test: validate slot test geometry
    [slot_cutout_invalid_width.scad]
2026-07-31 docs: document slot calibration workflow
2026-07-31 build: add STL export script
2026-07-31 docs: document STL generation
2026-07-31 release: prepare slot calibration release
2026-07-31 chore: Entwickleroberflächen auf Deutsch umstellen
    [body.scad, config.scad, debug_preview.scad, dimensions.scad, helpers.scad, label.scad, render.scad, slot_cutout_invalid_width.scad]
2026-07-31 fix: Slotlänge nach realem Testdruck auf 73,2 mm erhöhen
    [config.scad]
2026-07-31 docs: korrigierte Slotlänge dokumentieren
2026-08-01 fix: Dickenspiel nach Passungstest auf 1,2 mm erhöhen
    [config.scad]
2026-08-01 refactor: kalibrierte Entnahmegeometrie wiederverwenden
    [helpers.scad, slot_test.scad]
2026-08-01 refactor: Maße für variable Slotmatrizen ableiten
    [config.scad, dimensions.scad, slot_test.scad]
2026-08-01 feat: vollständige 20-Slot-Matrix und Grundkörper erzeugen
    [RAM_Box.scad, body.scad, config.scad, dimensions.scad, helpers.scad, render.scad]
2026-08-01 test: vollständigen Grundkörper und Prototyp-Export validieren
    [dimensions.scad]
2026-08-01 docs: vollständigen Grundkörper und Kalibrierwerte dokumentieren
2026-08-01 refactor: Kalibrierkennzeichnung gemeinsam verwenden
    [helpers.scad, slot_test.scad]
2026-08-01 feat: parametrische Stapelschnittstelle ergänzen
    [config.scad, dimensions.scad, stacking.scad]
2026-08-01 feat: kompaktes Stapelkalibrierpaar ergänzen
    [RAM_Box.scad, render.scad, stacking_test.scad]
2026-08-01 test: Stapelschnittstelle automatisiert validieren
    [debug_preview.scad, stacking_test.scad]
2026-08-01 test: Gesamtspiel aller Stapelvarianten absichern
    [dimensions.scad]
2026-08-01 fix: Eckkollisionen der Stapelnut beseitigen
    [dimensions.scad, stacking.scad, stacking_collision_check.scad]
2026-08-01 docs: Stapelkalibrierung und Prüfablauf dokumentieren
2026-08-01 fix: physisch validiertes Stapelspiel bestätigen
    [config.scad]
2026-08-01 refactor: Grundkörpermerkmale lokal parametrieren
    [body.scad, dimensions.scad, helpers.scad]
2026-08-01 feat: finale stapelbare 20-Slot-Box integrieren
    [RAM_Box.scad, config.scad, dimensions.scad, final_box.scad, render.scad]
2026-08-01 test: finale Box und Zweierstapel validieren
    [final_stack_collision_check.scad, final_two_box_stack.scad]
2026-08-01 build: finale STL reproduzierbar exportieren
2026-08-01 feat: adaptive Beschriftungsparameter ergänzen
    [config.scad, dimensions.scad]
2026-08-01 feat: variables Beschriftungsfeld integrieren
    [RAM_Box.scad, body.scad, final_box.scad, final_stack_collision_check.scad, final_two_box_stack.scad, label.scad]
